SSkrzypik/SkrzpkAmp/hardware/amplifier.kicad_pcb

## KiCad design hardware/amplifier.kicad_pcb (2024-12-02)

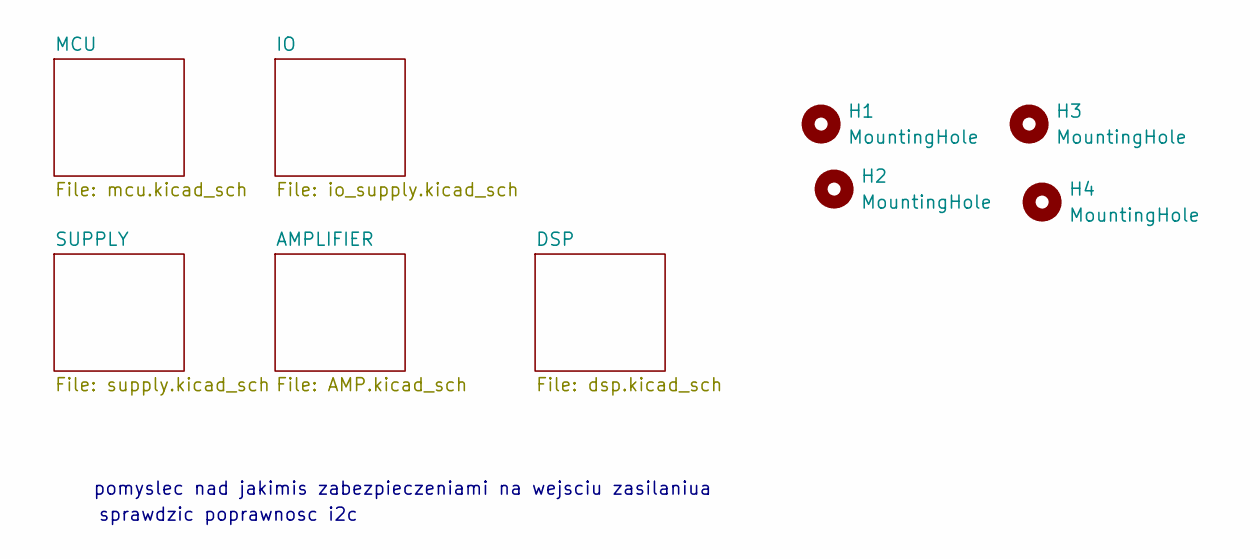
[picture p1: schematic amplifier.kicad_sch]

Parts:
H1, H2, H3, H4: MountingHole; MountingHole_3.2mm_M3

Notes on the sheet:
sprawdzic poprawnosc i2c
pomyslec nad jakimis zabezpieczeniami na wejsciu zasilaniua

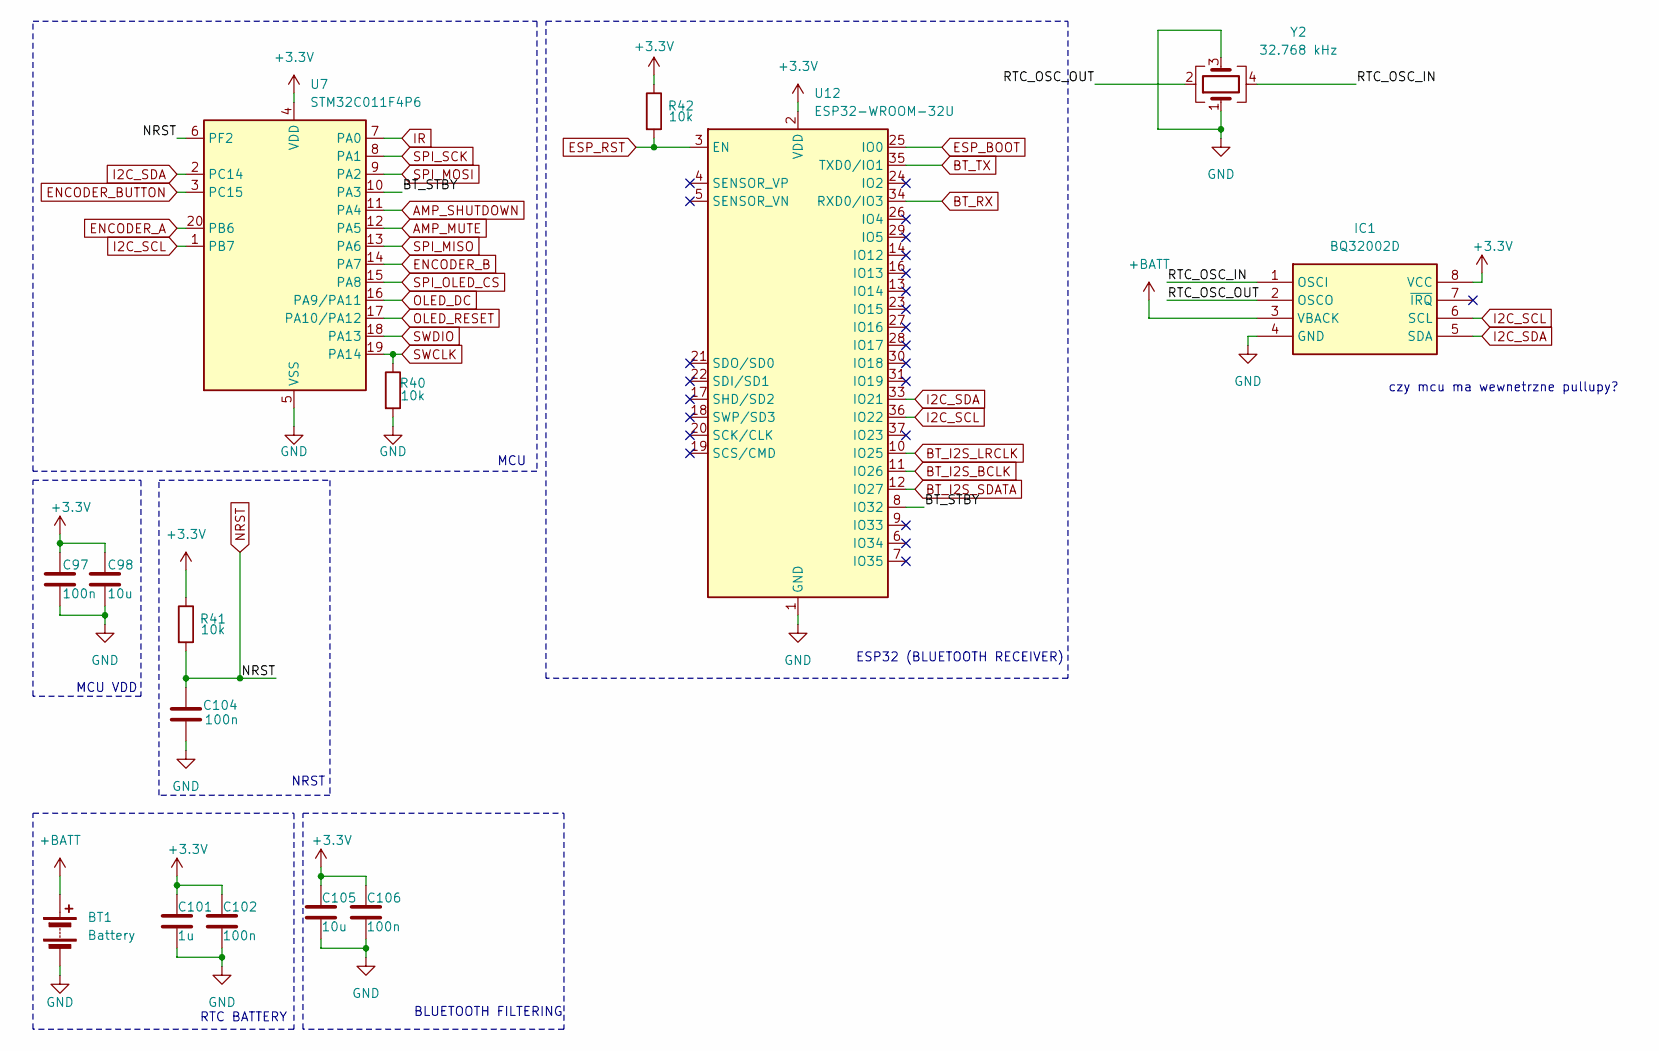
[picture p2: schematic mcu.kicad_sch]

Parts:
BT1: Battery; BatteryHolder_LINX_BAT-HLD-012-SMT
C97, C102, C104, C106: 100n; C_0603_1608Metric_Pad1.08x0.95mm_HandSolder
C98, C105: 10u; C_0603_1608Metric_Pad1.08x0.95mm_HandSolder
C101: 1u; C_0603_1608Metric_Pad1.08x0.95mm_HandSolder
IC1: BQ32002D; Mouser Part Number 595-BQ32002D
R40, R41, R42: 10k; R_0603_1608Metric_Pad0.98x0.95mm_HandSolder
U7: STM32C011F4P6; TSSOP-20_4.4x6.5mm_P0.65mm
U12: ESP32-WROOM-32U
Y2: 32.768 kHz; 32768K125PIMC306

Connections:
+BATT: BT1.1 (+), IC1.3 (VBACK)
/MCU/BT_STBY: U7.10 (PA3), U12.8 (IO32)
/MCU/RTC_OSC_IN: IC1.1 (OSCI), Y2.4
/MCU/RTC_OSC_OUT: IC1.2 (OSCO), Y2.2
AMP_MUTE: U7.12 (PA5); also elsewhere on the board
AMP_SHUTDOWN: U7.11 (PA4); also elsewhere on the board
BT_I2S_BCLK: U12.11 (IO26); also elsewhere on the board
BT_I2S_LRCLK: U12.10 (IO25); also elsewhere on the board
BT_I2S_SDATA: U12.12 (IO27); also elsewhere on the board
BT_RX: U12.34 (RXD0/IO3); also elsewhere on the board
BT_TX: U12.35 (TXD0/IO1); also elsewhere on the board
ENCODER_A: U7.20 (PB6); also elsewhere on the board
ENCODER_B: U7.14 (PA7); also elsewhere on the board
ENCODER_BUTTON: U7.3 (PC15); also elsewhere on the board
ESP_BOOT: U12.25 (IO0); also elsewhere on the board
ESP_RST: R42.2, U12.3 (EN); also elsewhere on the board
I2C_SCL: IC1.6 (SCL), U7.1 (PB7), U12.36 (IO22); also elsewhere on the board
I2C_SDA: IC1.5 (SDA), U7.2 (PC14), U12.33 (IO21); also elsewhere on the board
IR: U7.7 (PA0); also elsewhere on the board
NRST: C104.1, R41.2, U7.6 (PF2); also elsewhere on the board
OLED_DC: U7.16 (PA9/PA11); also elsewhere on the board
OLED_RESET: U7.17 (PA10/PA12); also elsewhere on the board
SPI_MISO: U7.13 (PA6); also elsewhere on the board
SPI_MOSI: U7.9 (PA2); also elsewhere on the board
SPI_OLED_CS: U7.15 (PA8); also elsewhere on the board
SPI_SCK: U7.8 (PA1); also elsewhere on the board
SWCLK: R40.1, U7.19 (PA14); also elsewhere on the board
SWDIO: U7.18 (PA13); also elsewhere on the board

Notes on the sheet:
MCU
ESP32 (BLUETOOTH RECEIVER)
czy mcu ma wewnetrzne pullupy?
RTC BATTERY
NRST
MCU VDD
BLUETOOTH FILTERING

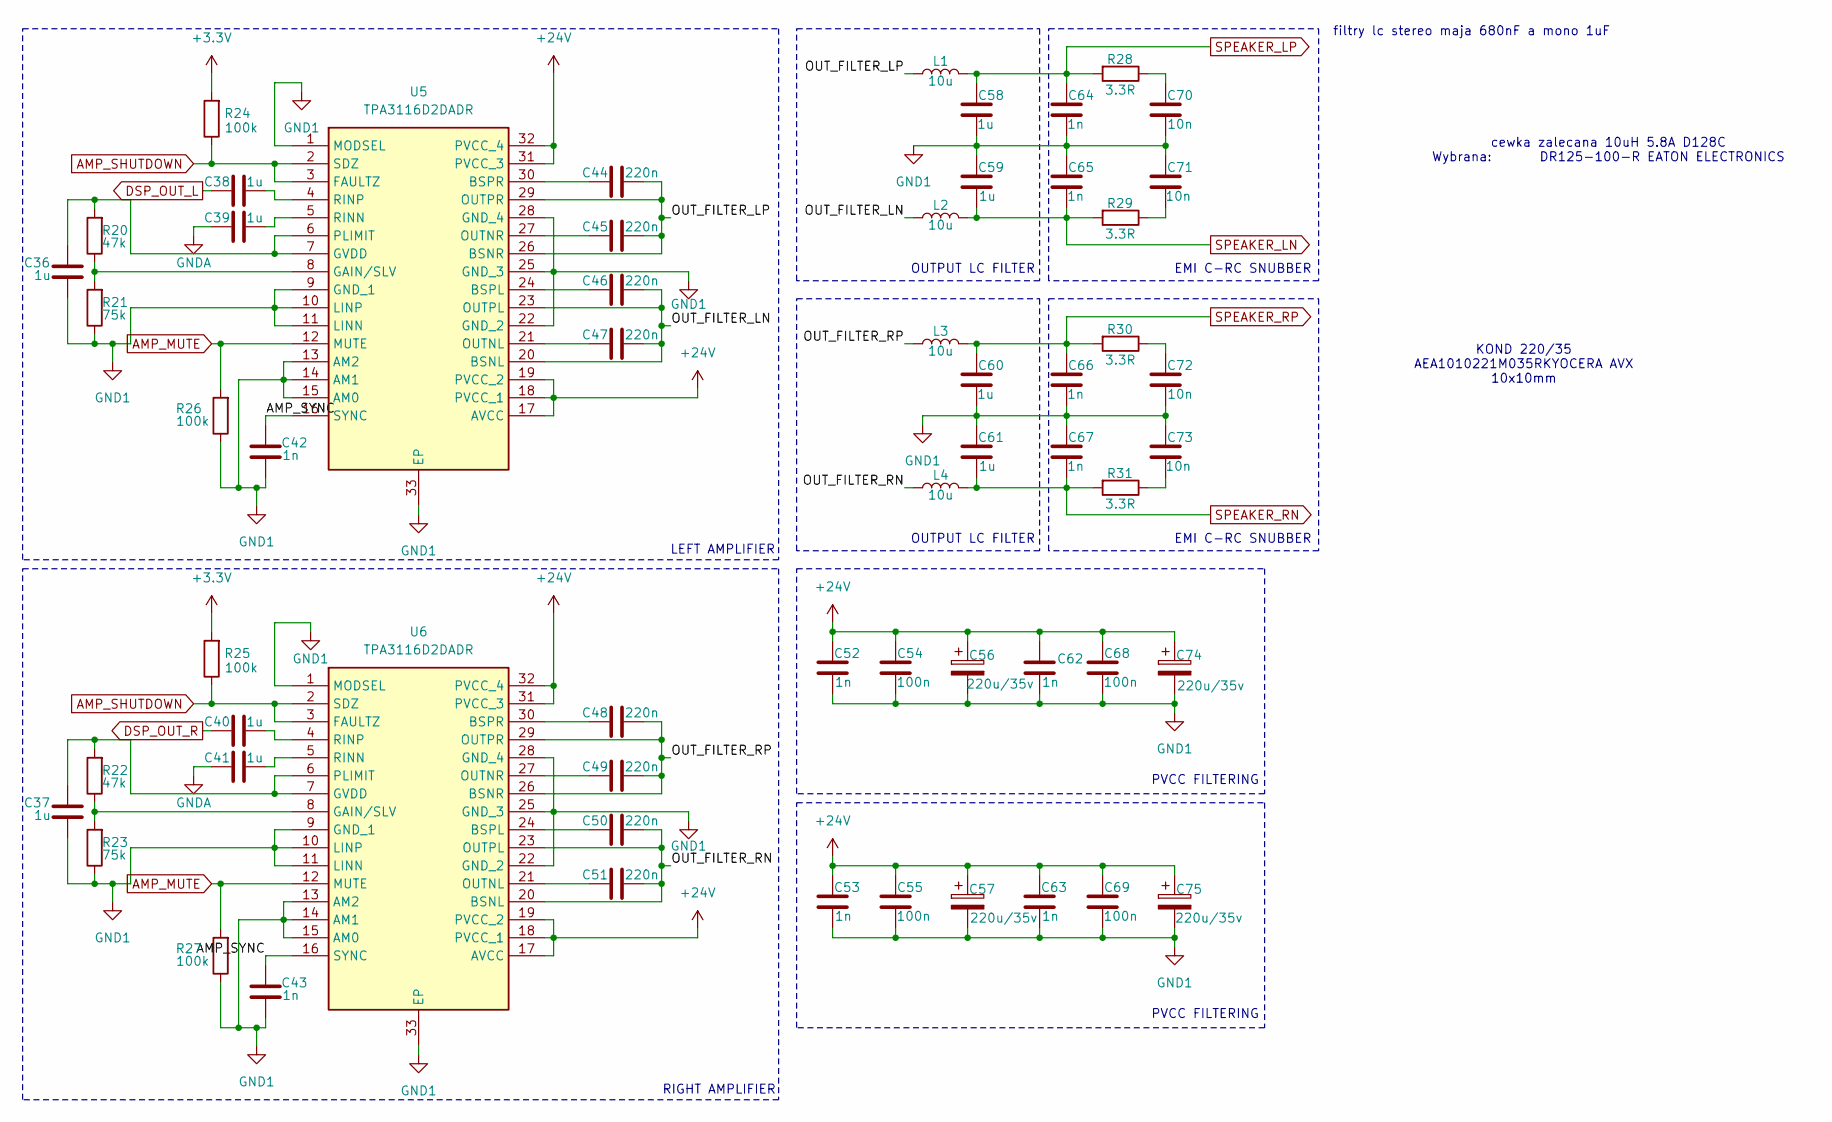
[picture p3: schematic AMP.kicad_sch]

Parts:
C36, C37, C38, C39, C40, C41, C58, C59, C60, C61: 1u; C_0603_1608Metric_Pad1.08x0.95mm_HandSolder
C42, C43, C52, C53, C62, C63, C64, C65, C66, C67: 1n; C_0603_1608Metric_Pad1.08x0.95mm_HandSolder
C44, C45, C46, C47, C48, C49, C50, C51: 220n; C_0603_1608Metric_Pad1.08x0.95mm_HandSolder
C54, C55, C68, C69: 100n; C_0603_1608Metric_Pad1.08x0.95mm_HandSolder
C56, C57, C74, C75: 220u/35v; CP_Elec_10x10
C70, C71, C72, C73: 10n; C_0603_1608Metric_Pad1.08x0.95mm_HandSolder
L1, L2, L3, L4: 10u; DR127-100-R
R20, R22: 47k; R_0603_1608Metric_Pad0.98x0.95mm_HandSolder
R21, R23: 75k; R_0603_1608Metric_Pad0.98x0.95mm_HandSolder
R24, R25, R26, R27: 100k; R_0603_1608Metric_Pad0.98x0.95mm_HandSolder
R28, R29, R30, R31: 3.3R; R_0603_1608Metric_Pad0.98x0.95mm_HandSolder
U5, U6: TPA3116D2DADR; SOP65P810X120-33N; Manufacturer_Part_Number TPA3116D2DADR

Connections:
/AMPLIFIER/AMP_SYNC: C42.1, C43.1, U5.16 (SYNC), U6.16 (SYNC)
/AMPLIFIER/OUT_FILTER_LN: C46.1, C47.1, L2.1, U5.20 (BSNL), U5.23 (OUTPL)
/AMPLIFIER/OUT_FILTER_LP: C44.1, C45.1, L1.1, U5.26 (BSNR), U5.29 (OUTPR)
/AMPLIFIER/OUT_FILTER_RN: C50.1, C51.1, L4.1, U6.20 (BSNL), U6.23 (OUTPL)
/AMPLIFIER/OUT_FILTER_RP: C48.1, C49.1, L3.1, U6.26 (BSNR), U6.29 (OUTPR)
AMP_MUTE: R26.2, R27.2, U5.12 (MUTE), U6.12 (MUTE); also elsewhere on the board
AMP_SHUTDOWN: R24.1, R25.1, U5.2 (SDZ), U5.3 (FAULTZ), U6.2 (SDZ), U6.3 (FAULTZ); also elsewhere on the board
DSP_OUT_L: C38.2; also elsewhere on the board
DSP_OUT_R: C40.2; also elsewhere on the board
GND1: C36.2, C37.2, C42.2, C43.2, C52.2, C53.2, C54.2, C55.2, C56.2, C57.2, C58.2, C59.1, C60.2, C61.1, C62.2, C63.2, C64.2, C65.1, C66.2, C67.1, C68.2, C69.2, C70.2, C71.1, C72.2, C73.1, C74.2, C75.2, R21.1, R23.1, R26.1, R27.1, U5.1 (MODSEL), U5.9 (GND_1), U5.10 (LINP), U5.11 (LINN), U5.13 (AM2), U5.14 (AM1), U5.15 (AM0), U5.22 (GND_2), U5.25 (GND_3), U5.28 (GND_4), U5.33 (EP), U6.1 (MODSEL), U6.9 (GND_1), U6.10 (LINP), U6.11 (LINN), U6.13 (AM2), U6.14 (AM1), U6.15 (AM0), U6.22 (GND_2), U6.25 (GND_3), U6.28 (GND_4), U6.33 (EP); also elsewhere on the board
unnamed: C70.1, R28.1
unnamed: C71.2, R29.1
unnamed: C72.1, R30.1
unnamed: C73.2, R31.1
unnamed: C46.2, U5.24 (BSPL)
unnamed: C44.2, U5.30 (BSPR)
unnamed: R20.1, R21.2, U5.8 (GAIN/SLV)
unnamed: C36.1, R20.2, U5.6 (PLIMIT), U5.7 (GVDD)
unnamed: C47.2, U5.21 (OUTNL)
unnamed: C45.2, U5.27 (OUTNR)
unnamed: C39.1, U5.5 (RINN)
unnamed: C38.1, U5.4 (RINP)
unnamed: C50.2, U6.24 (BSPL)
unnamed: C48.2, U6.30 (BSPR)
unnamed: R22.1, R23.2, U6.8 (GAIN/SLV)
unnamed: C37.1, R22.2, U6.6 (PLIMIT), U6.7 (GVDD)
unnamed: C51.2, U6.21 (OUTNL)
unnamed: C49.2, U6.27 (OUTNR)
unnamed: C41.1, U6.5 (RINN)
unnamed: C40.1, U6.4 (RINP)
SPEAKER_LN: C59.2, C65.2, L2.2, R29.2; also elsewhere on the board
SPEAKER_LP: C58.1, C64.1, L1.2, R28.2; also elsewhere on the board
SPEAKER_RN: C61.2, C67.2, L4.2, R31.2; also elsewhere on the board
SPEAKER_RP: C60.1, C66.1, L3.2, R30.2; also elsewhere on the board

Notes on the sheet:
PVCC FILTERING
EMI C-RC SNUBBER
RIGHT AMPLIFIER
filtry lc stereo maja 680nF a mono 1uF
OUTPUT LC FILTER
cewka zalecana 10uH 5.8A D128C Wybrana: DR125-100-R EATON ELECTRONICS
LEFT AMPLIFIER
KOND 220/35 AEA1010221M035RKYOCERA AVX 10x10mm

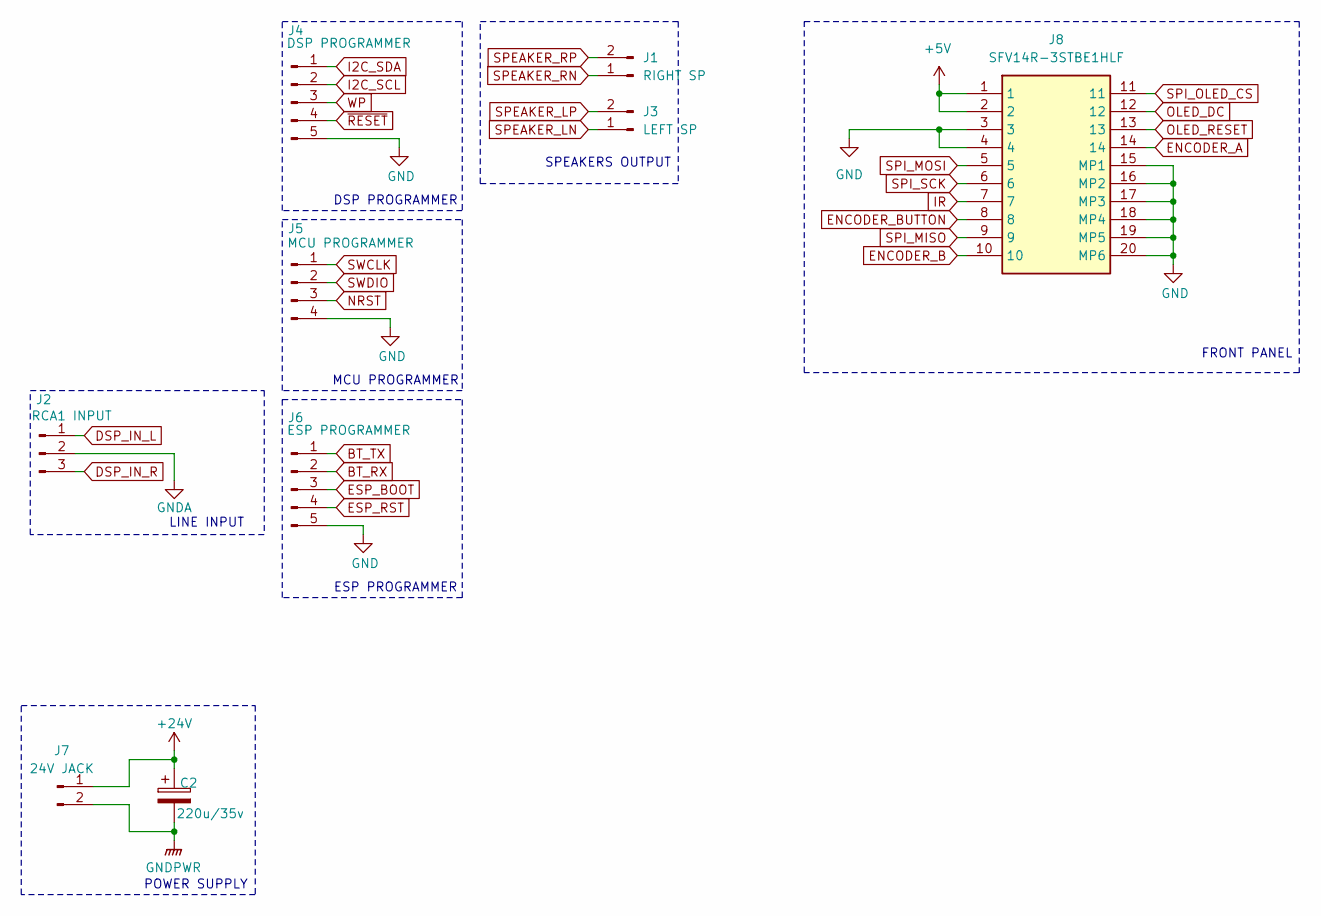
[picture p4: schematic io_supply.kicad_sch]

Parts:
C2: 220u/35v; CP_Elec_10x10
J1: RIGHT SP; 2828362
J2: RCA1 INPUT; JST_PH_B3B-PH-K_1x03_P2.00mm_Vertical
J3: LEFT SP; 2828362
J4: DSP PROGRAMMER; PinHeader_1x05_P2.54mm_Vertical
J5: MCU PROGRAMMER; PinHeader_1x04_P2.54mm_Vertical
J6: ESP PROGRAMMER; PinHeader_1x05_P2.54mm_Vertical
J7: 24V JACK; 2828362
J8: SFV14R-3STBE1HLF; SFV14R3STBE1HLF; Manufacturer_Part_Number SFV14R-3STBE1HLF

Connections:
BT_RX: J6.2; also elsewhere on the board
BT_TX: J6.1; also elsewhere on the board
DSP_IN_R: J2.3; also elsewhere on the board
ENCODER_A: J8.14; also elsewhere on the board
ENCODER_B: J8.10; also elsewhere on the board
ENCODER_BUTTON: J8.8; also elsewhere on the board
ESP_BOOT: J6.3; also elsewhere on the board
ESP_RST: J6.4; also elsewhere on the board
I2C_SCL: J4.2; also elsewhere on the board
I2C_SDA: J4.1; also elsewhere on the board
IR: J8.7; also elsewhere on the board
NRST: J5.3; also elsewhere on the board
OLED_DC: J8.12; also elsewhere on the board
OLED_RESET: J8.13; also elsewhere on the board
SPEAKER_LN: J3.1; also elsewhere on the board
SPEAKER_LP: J3.2; also elsewhere on the board
SPEAKER_RN: J1.1; also elsewhere on the board
SPEAKER_RP: J1.2; also elsewhere on the board
SPI_MISO: J8.9; also elsewhere on the board
SPI_MOSI: J8.5; also elsewhere on the board
SPI_OLED_CS: J8.11; also elsewhere on the board
SPI_SCK: J8.6; also elsewhere on the board
SWCLK: J5.1; also elsewhere on the board
SWDIO: J5.2; also elsewhere on the board
WP: J4.3; also elsewhere on the board
~RESET: J4.4; also elsewhere on the board

Notes on the sheet:
POWER SUPPLY
MCU PROGRAMMER
DSP PROGRAMMER
FRONT PANEL
SPEAKERS OUTPUT
LINE INPUT
ESP PROGRAMMER

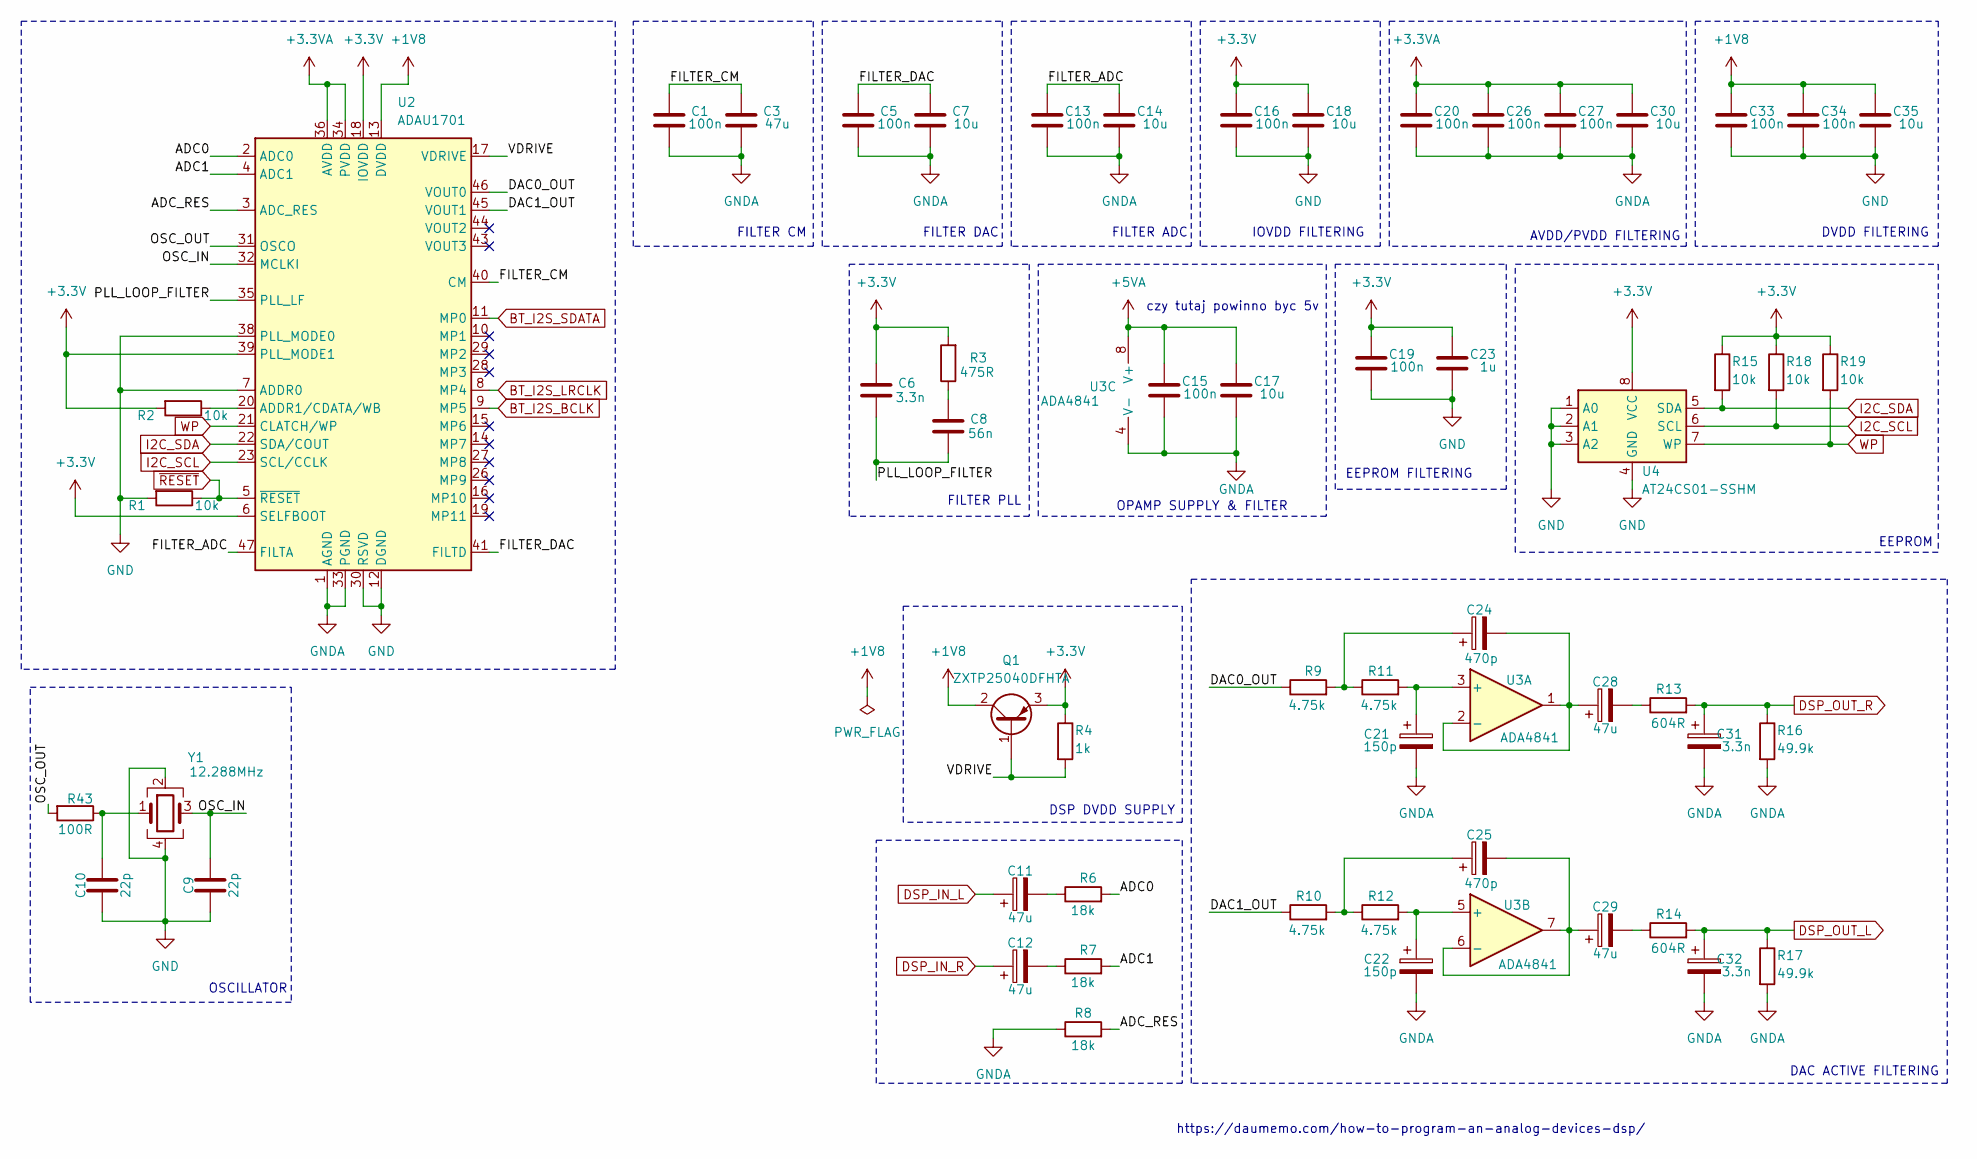
[picture p5: schematic dsp.kicad_sch]

Parts:
C1, C5, C13, C15, C16, C19, C20, C26, C27, C33, C34: 100n; C_0603_1608Metric_Pad1.08x0.95mm_HandSolder
C3, C11, C12, C28, C29: 47u; C_0603_1608Metric_Pad1.08x0.95mm_HandSolder
C6, C31, C32: 3.3n; C_0603_1608Metric_Pad1.08x0.95mm_HandSolder
C7, C14, C17, C18, C30, C35: 10u; C_0603_1608Metric_Pad1.08x0.95mm_HandSolder
C8: 56n; C_0603_1608Metric_Pad1.08x0.95mm_HandSolder
C9, C10: 22p; C_0603_1608Metric_Pad1.08x0.95mm_HandSolder
C21, C22: 150p; C_0603_1608Metric_Pad1.08x0.95mm_HandSolder
C23: 1u; C_0603_1608Metric_Pad1.08x0.95mm_HandSolder
C24, C25: 470p; C_0603_1608Metric_Pad1.08x0.95mm_HandSolder
Q1: ZXTP25040DFHTA; SOT-23
R1, R2, R15, R18, R19: 10k; R_0603_1608Metric_Pad0.98x0.95mm_HandSolder
R3: 475R; R_0603_1608Metric_Pad0.98x0.95mm_HandSolder
R4: 1k; R_0603_1608Metric_Pad0.98x0.95mm_HandSolder
R6, R7, R8: 18k; R_0603_1608Metric_Pad0.98x0.95mm_HandSolder
R9, R10, R11, R12: 4.75k; R_0603_1608Metric_Pad0.98x0.95mm_HandSolder
R13, R14: 604R; R_0603_1608Metric_Pad0.98x0.95mm_HandSolder
R16, R17: 49.9k; R_0603_1608Metric_Pad0.98x0.95mm_HandSolder
R43: 100R; R_0603_1608Metric_Pad0.98x0.95mm_HandSolder
U2: ADAU1701; LQFP-48_7x7mm_P0.5mm
U3: ADA4841; MSOP-8_3x3mm_P0.65mm
U4: AT24CS01-SSHM; SOIC127P600X175-8N
Y1: 12.288MHz; ABM3B

Connections:
+1V8: C33.1, C34.1, C35.1, Q1.2 (C), U2.13 (DVDD), U2.24 (DVDD)
/DSP/ADC0: R6.2, U2.2 (ADC0)
/DSP/ADC1: R7.2, U2.4 (ADC1)
/DSP/ADC_RES: R8.2, U2.3 (ADC_RES)
/DSP/DAC0_OUT: R9.1, U2.46 (VOUT0)
/DSP/DAC1_OUT: R10.1, U2.45 (VOUT1)
/DSP/FILTER_ADC: C13.1, C14.1, U2.47 (FILTA)
/DSP/OSC_OUT: R43.2, U2.31 (OSCO)
/DSP/VDRIVE: Q1.1 (B), R4.2, U2.17 (VDRIVE)
BT_I2S_BCLK: U2.9 (MP5); also elsewhere on the board
BT_I2S_LRCLK: U2.8 (MP4); also elsewhere on the board
BT_I2S_SDATA: U2.11 (MP0); also elsewhere on the board
DSP_IN_R: C12.1; also elsewhere on the board
DSP_OUT_L: C32.1, R14.2, R17.1; also elsewhere on the board
DSP_OUT_R: C31.1, R13.2, R16.1; also elsewhere on the board
I2C_SCL: R18.2, U2.23 (SCL/CCLK), U4.6 (SCL); also elsewhere on the board
I2C_SDA: R15.2, U2.22 (SDA/COUT), U4.5 (SDA); also elsewhere on the board
unnamed: C12.2, R7.1
unnamed: C24.1, R9.2, R11.1
unnamed: C25.1, R10.2, R12.1
unnamed: C28.2, R13.1
unnamed: C29.2, R14.1
unnamed: R2.1, U2.20 (ADDR1/CDATA/WB)
unnamed: C21.1, R11.2, U3.3 (+)
unnamed: C24.2, C28.1, U3.1, U3.2 (-)
unnamed: C22.1, R12.2, U3.5 (+)
unnamed: C25.2, C29.1, U3.6 (-), U3.7
WP: R19.2, U2.21 (CLATCH/WP), U4.7 (WP); also elsewhere on the board
~RESET: R1.1, U2.5 (~RESET); also elsewhere on the board

Notes on the sheet:
EEPROM
DAC ACTIVE FILTERING
AVDD/PVDD FILTERING
FILTER PLL
DVDD FILTERING
https://daumemo.com/how-to-program-an-analog-devices-dsp/
FILTER DAC
OPAMP SUPPLY & FILTER
czy tutaj powinno byc 5v
EEPROM FILTERING
FILTER ADC
FILTER CM
OSCILLATOR
IOVDD FILTERING
DSP DVDD SUPPLY

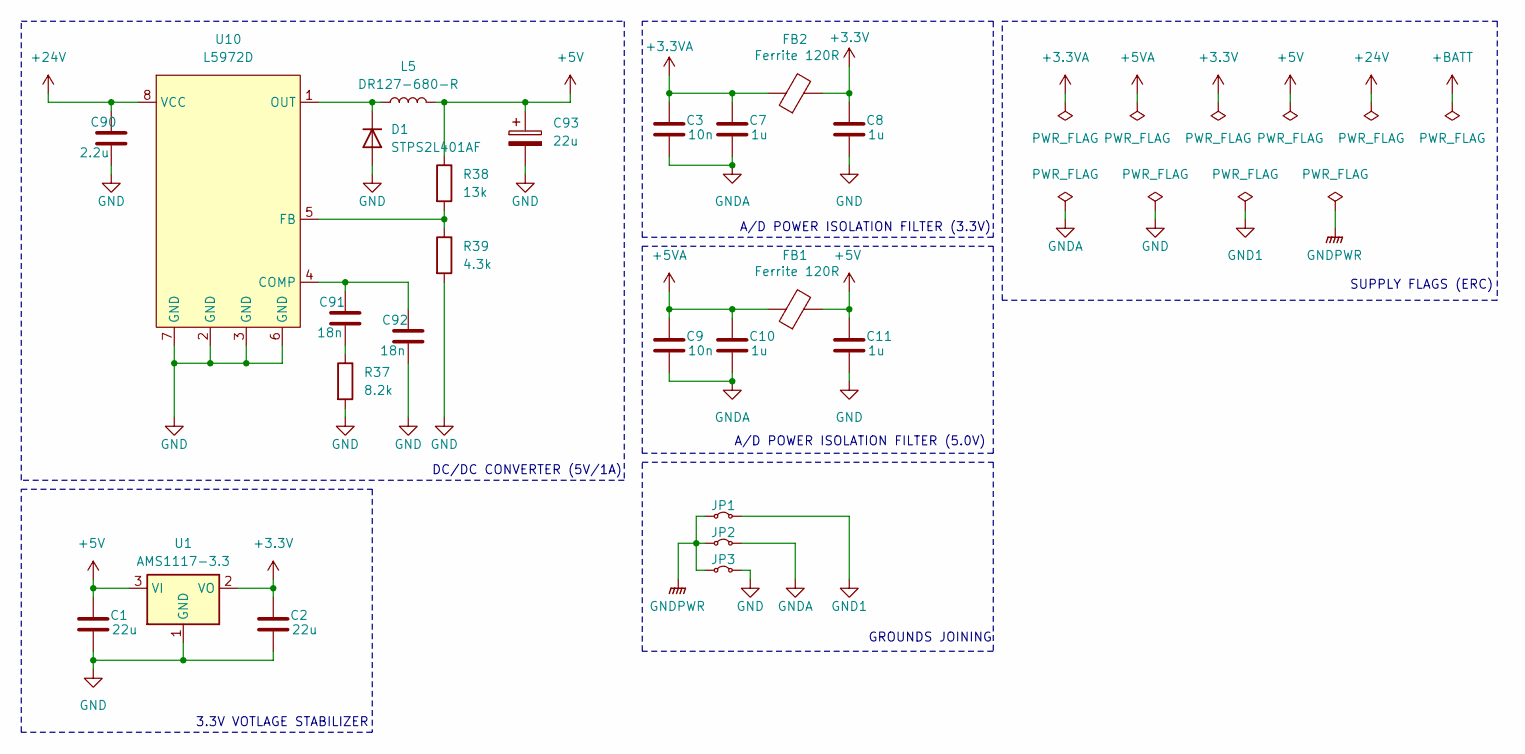
[picture p6: schematic supply.kicad_sch]

Parts:
C1, C2, C93: 22u; C_0603_1608Metric_Pad1.08x0.95mm_HandSolder
C3, C9: 10n; C_0603_1608Metric_Pad1.08x0.95mm_HandSolder
C7, C8, C10, C11: 1u; C_0603_1608Metric_Pad1.08x0.95mm_HandSolder
C90: 2.2u; C_0603_1608Metric_Pad1.08x0.95mm_HandSolder
C91, C92: 18n; C_0603_1608Metric_Pad1.08x0.95mm_HandSolder
D1: STPS2L401AF; STPS2L40AF
FB1, FB2: Ferrite 120R; L_0805_2012Metric_Pad1.05x1.20mm_HandSolder
JP1, JP2, JP3: Jumper_2_Small_Bridged; R_1210_3225Metric_Pad1.30x2.65mm_HandSolder
L5: DR127-680-R; DR127-100-R
R37: 8.2k; R_0603_1608Metric_Pad0.98x0.95mm_HandSolder
R38: 13k; R_0603_1608Metric_Pad0.98x0.95mm_HandSolder
R39: 4.3k; R_0603_1608Metric_Pad0.98x0.95mm_HandSolder
U1: AMS1117-3.3; SOT-223-3_TabPin2
U10: L5972D; SO-8_3.9x4.9mm_P1.27mm

Connections:
GND1: JP1.2 (B); also elsewhere on the board
unnamed: C91.2, R37.1
unnamed: D1.1 (K), L5.1, U10.1 (OUT)
unnamed: C91.1, C92.1, U10.4 (COMP)
unnamed: R38.2, R39.1, U10.5 (FB)

Notes on the sheet:
SUPPLY FLAGS (ERC)
A/D POWER ISOLATION FILTER (5.0V)
DC/DC CONVERTER (5V/1A)
A/D POWER ISOLATION FILTER (3.3V)
GROUNDS JOINING
3.3V VOTLAGE STABILIZER

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
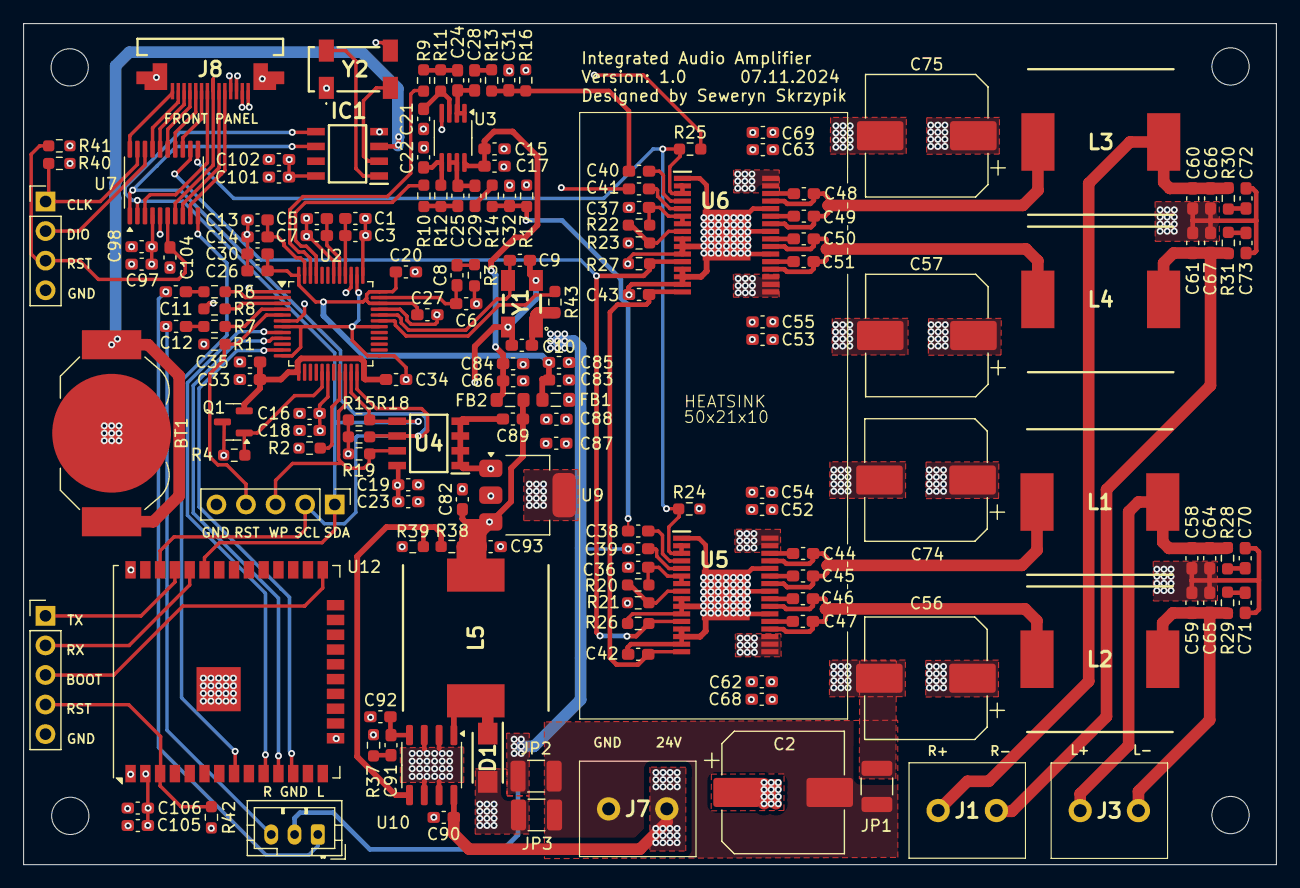
[picture p7: board amplifier.kicad_pcb from above]

Board: 4 copper layers, 107.6 x 72.2 mm, 167 parts (0 on the bottom side), 102 nets.

Other parts of the board:
C82, C87: 22u; C_0603_1608Metric_Pad1.08x0.95mm_HandSolder
C83, C84: 10n; C_0603_1608Metric_Pad1.08x0.95mm_HandSolder
C85, C86, C88, C89: 1u; C_0603_1608Metric_Pad1.08x0.95mm_HandSolder
U9: AMS1117-3.3; SOT-223-3_TabPin2
